snell-matthew-a/MicroAdjust/README.md

# MicroAdjust

This is a mostly 3d printed micro-adjust jig made to fit the fence for a Harvey table saw.  Includes the stl files for the printed parts, as well as the Fusion 360 source file where I modeled the jig.

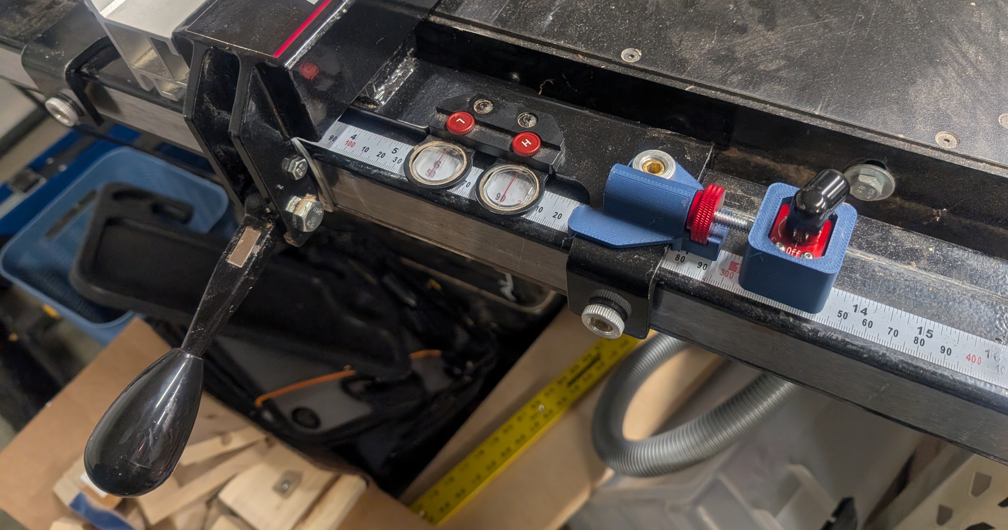
[picture p1: images/img001.jpg]


It's meant to work similarly to the [T-Fence MicroMag Adjuster](https://canyonfiretools.com/shop/ols/products/t-fence-micromag-adjuster-3fadef) made by Canyon Fire Tools, which looks great but costs $110 plus another $30 for the magswitch.  All in, this version cost under $5 for the jig, and under $35 in total.

Project includes the printable stl files, as well as the source Fusion 360 file where I modeled the parts for the jig.  

## Materials

| Quantity | Item | Cost[^1] |
|---|---|---|
|1|Mag-mate JP095R| [$28.65](https://www.amazon.com/dp/B075RDY7CQ)|
|1|1/4"-20 Female Thumb Wheel| [$2.49](https://www.amazon.com/dp/B06XYDT8TY)|
|1|2 1/2" 1/4"-20 T-Track Bolt| [$0.60](https://www.amazon.com/dp/B0765R88Z7)|
|60g| PLA - Matte Dark Blue (11602)| [$0.78](https://us.store.bambulab.com/products/pla-matte?variant=41884207972488)|

I printed the parts at 100% infill out of PLA, using ~60g of filament in total.  The printed components are slightly different to what's shown in the pictures due to cosmetic changes I made when going back and cleaning up my messy workflow.

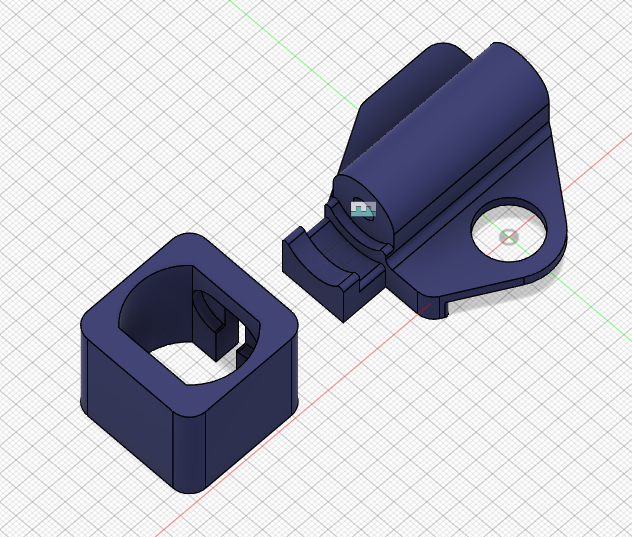
[picture p2: images/img003.png]


[^1]: PLA was purchased in bulk on sale.  I'm only including the 1 thumb wheel and bolt used in the cost here because the rest will be used in other projects eventually, probably

## Process

The two parts for the jig were printed in PLA at 100% infill.  I reamed the hole in the main body with a 1/4" drill bit by hand, but no other post-processing was necessary, and the parts all fit together without glue or fasteners needed.

The main body fits over the fence's right adjustment screw and is held down by the fence's thumb wheel.  Then, just set the thumb wheel for the jig in place, slot the t-track bolt in, and screw it together.  The t-track bolt is then held in place by the body of the magswitch.

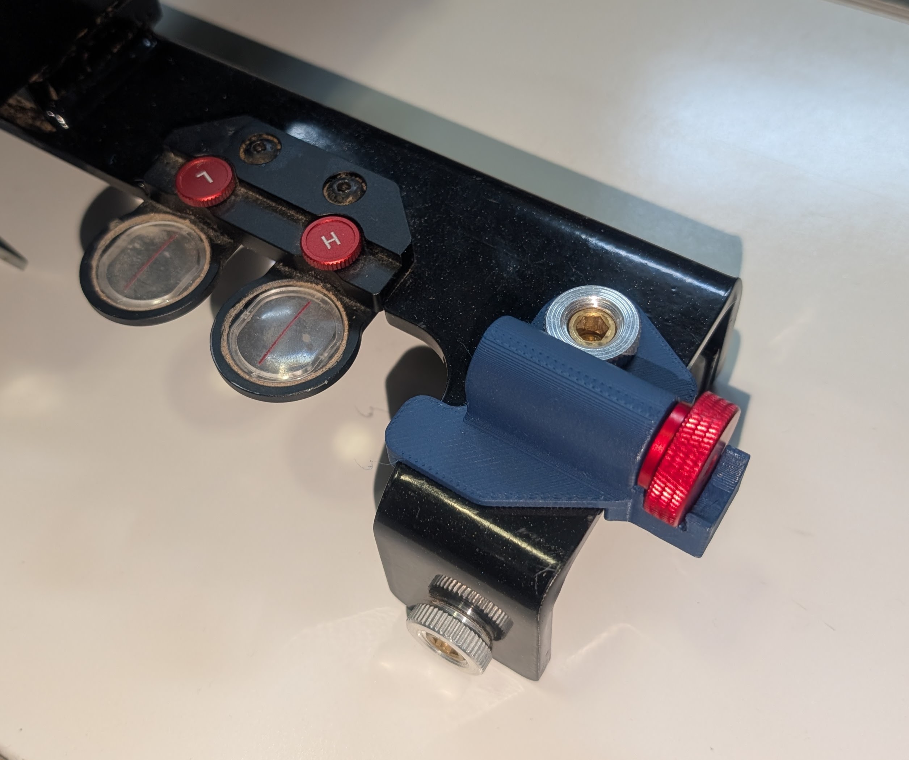
[picture p3: images/img002.jpg]


## Adapting to other table saws

The basic design could be adjusted to work for most t-style fences:

* The bottom part of the main body would need to be adjusted to match up with your fence.
* Another option would be to use a strong permanent magnet to hold this side in place, similar to the original version by Canyon Fire Tools

Besides that, the cutout for the t-slot bolt could be adjusted to work with a carriage bolt or a hex head, and the spacing for the thumb wheel could be adjusted to work with other options.

It would be fairly straightforward to make something similar out of wood.  Mag-mate suggests a 30mm forstner bit for making the hole for the magswitch.

## Change History

|Version|Changes|
|---|---|
|v2|Added a grub screw to the magswitch holder and adjusted the holder down by 3mm|
