snell-matthew-a/MicroAdjust/cad/Micro Adjust v2.stl

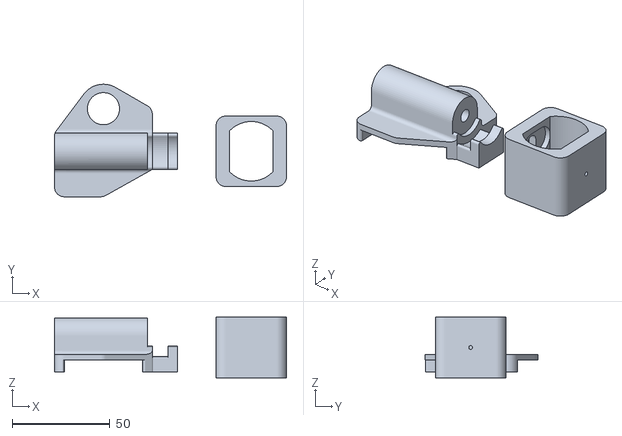
[picture p4: CAD file, 2025-02-08]
cad/Micro Adjust v2.stl
118.5 x 57.5 x 31.0
