snell-matthew-a/MicroAdjust/(list of files, cad)

Other CAD files:
cad/Micro Adjust v2.f3d
