snell-matthew-a/MicroAdjust/(commit log)

2025-01-31 Added photos
    [Micro Adjust v1.f3d, Micro Adjust v1.stl]
2025-01-31 screenshot of printable parts
2025-02-08 Added grub screw, adjusted z-height
    [Micro Adjust v1.f3d, Micro Adjust v1.stl, Micro Adjust v2.f3d, Micro Adjust v2.stl]
